bbarke/nexstar_gps/src/skysync_gps_clone.png

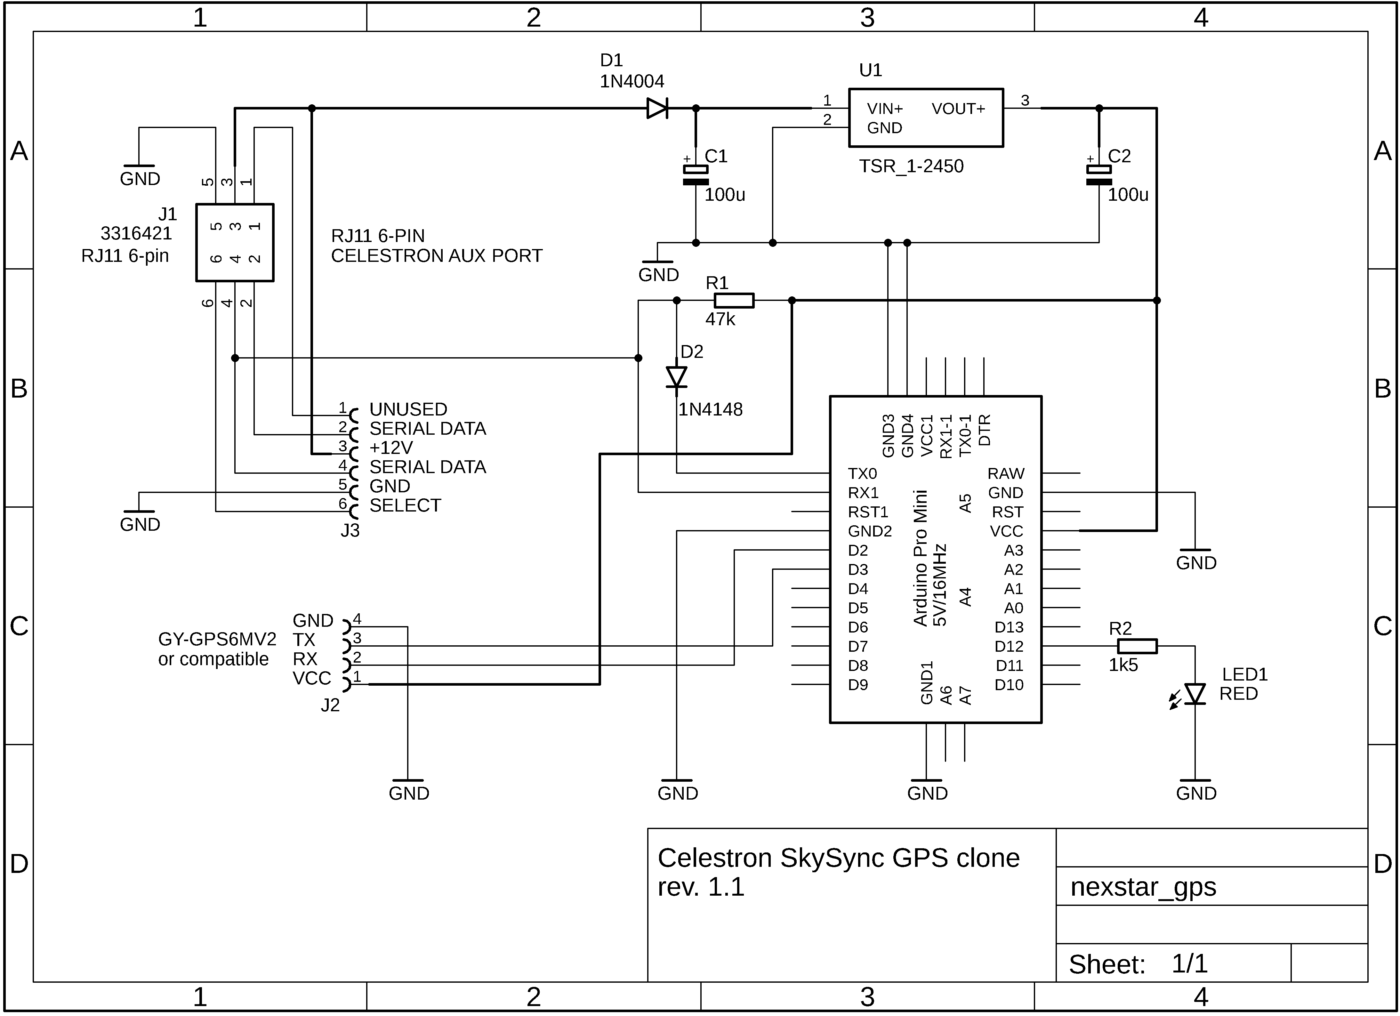
src/skysync_gps_clone.png
