bbarke/nexstar_gps/src/Celestron NXW434 Schematic.pdf

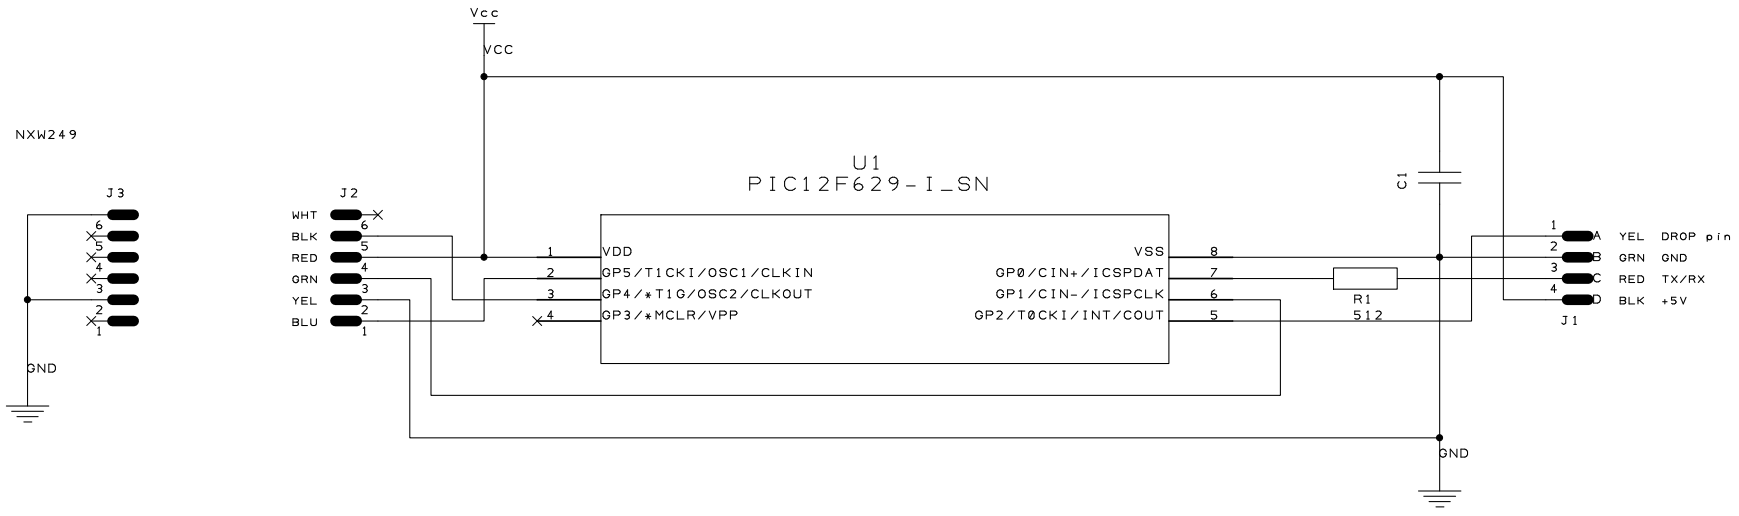
[picture p2: page 1]
