bbarke/nexstar_gps/src/Celestron Arduino Nano GPS for AUX port.pdf

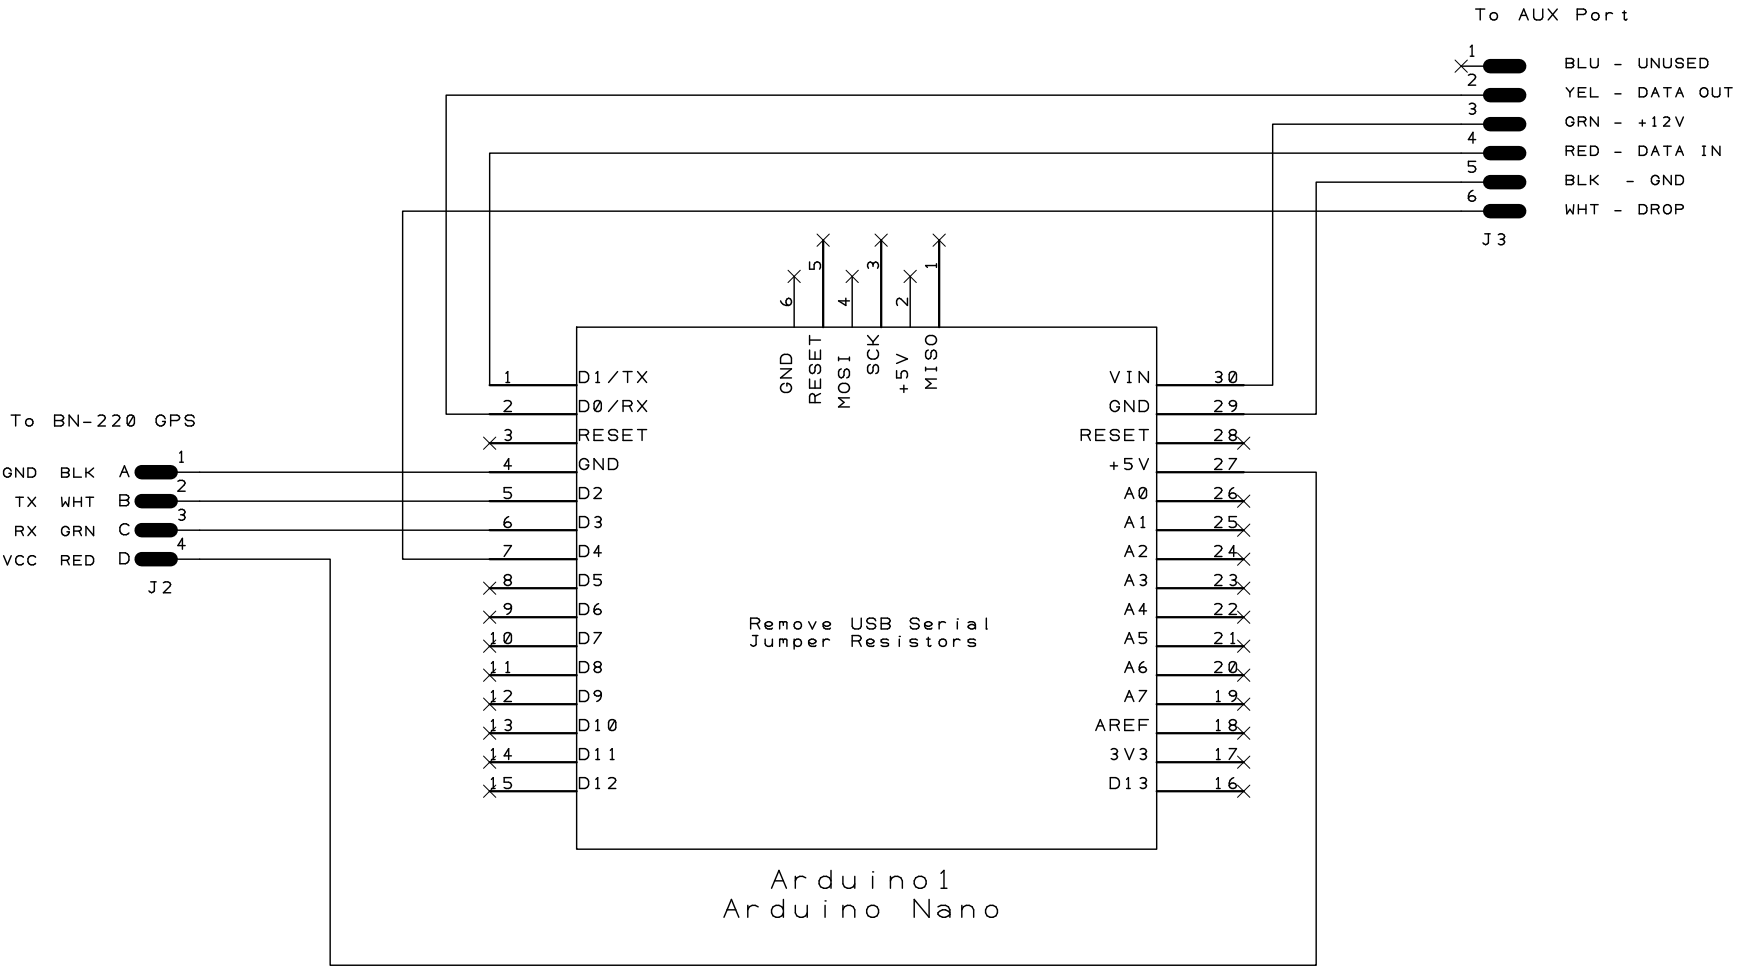
[picture p3: page 1]
