bbarke/nexstar_gps/src/Celestron Arduino Nano GPS.pdf

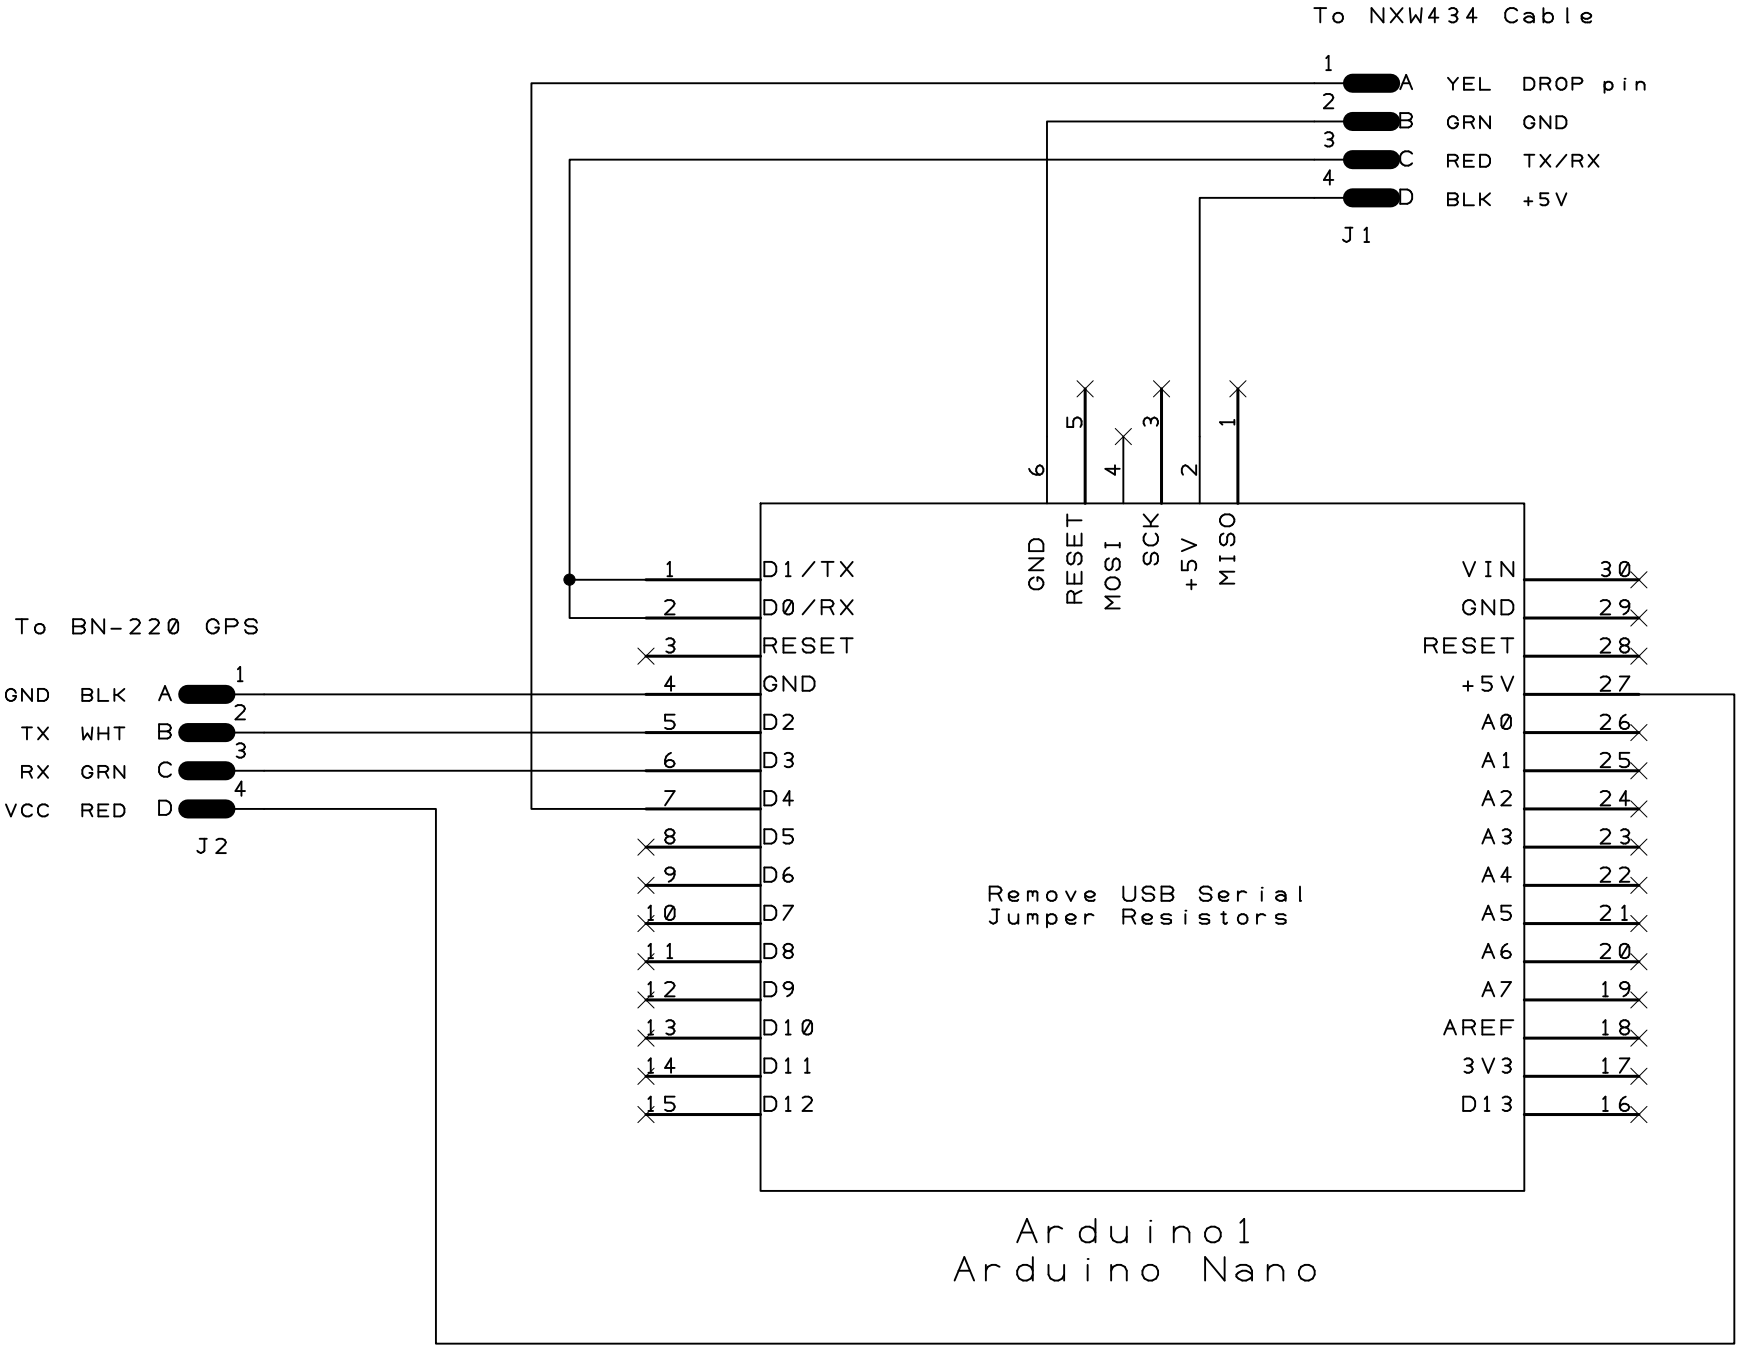
[picture p4: page 1]
