bbarke/nexstar_gps/src/scope_temperature.h

#ifndef ScopeTemp_H
#define ScopeTemp_H

#include <Wire.h>
#include <SPI.h>
#include <Adafruit_Sensor.h>
#include <Adafruit_BME280.h>

class ScopeTemperature {
public:
    void begin();
    uint8_t getHumidity();
    float getTemperature();
    float getDewpoint();
    bool update();

private:
    float cToF(float c);

};

#endif
