bbarke/nexstar_gps/(commit log)

2019-01-22 added GPS location lat/lng encoding, LED status for main comm and GPS quality, minor bug-fixies and changes for use with Advanced VX mount
2019-02-08 SkySync GPS clone schematics diagram
2020-05-07 Add files via upload
    Eliminating need for diode or other support circuitry on Celestron TX side. Added missing control line to pull the DROP (CTS/RTS) pin down when transmitting.
    Added support for GNSS receiver (e.g. BN-220).
    Started from bebrown original, but discovered that wasn't complete. Brought in fixes from ForestTree's branch.
2020-05-07 Schematics for NXW434, Arduino Nano NexStar GPS, and AUX Port
    Adding schematics for the NXW434 board, the Ardunio Nano based solution to replace it, and the Arduino Nano based AUX port solution.
2020-05-08 Enlarged drawing scale
    Enlarged drawing scale and changed AUX port schematic to separate TX/RX lines (although it can go both ways).
2023-11-03 Fixed some oled outputs
    [main.cpp, oled.cpp, oled.h]
2023-11-12 Working oled screen and temperature. Had to use a lighter weight screen library because the pro mini kept running out of memory and crashing
    [main.cpp, oled.cpp, oled.h, scope_temperature.cpp, scope_temperature.h]
